indrekluuk/PlantWateringSystem/PCB/WateringSystem.kicad_pcb

## KiCad design PCB/WateringSystem.kicad_pcb (2018-07-01)

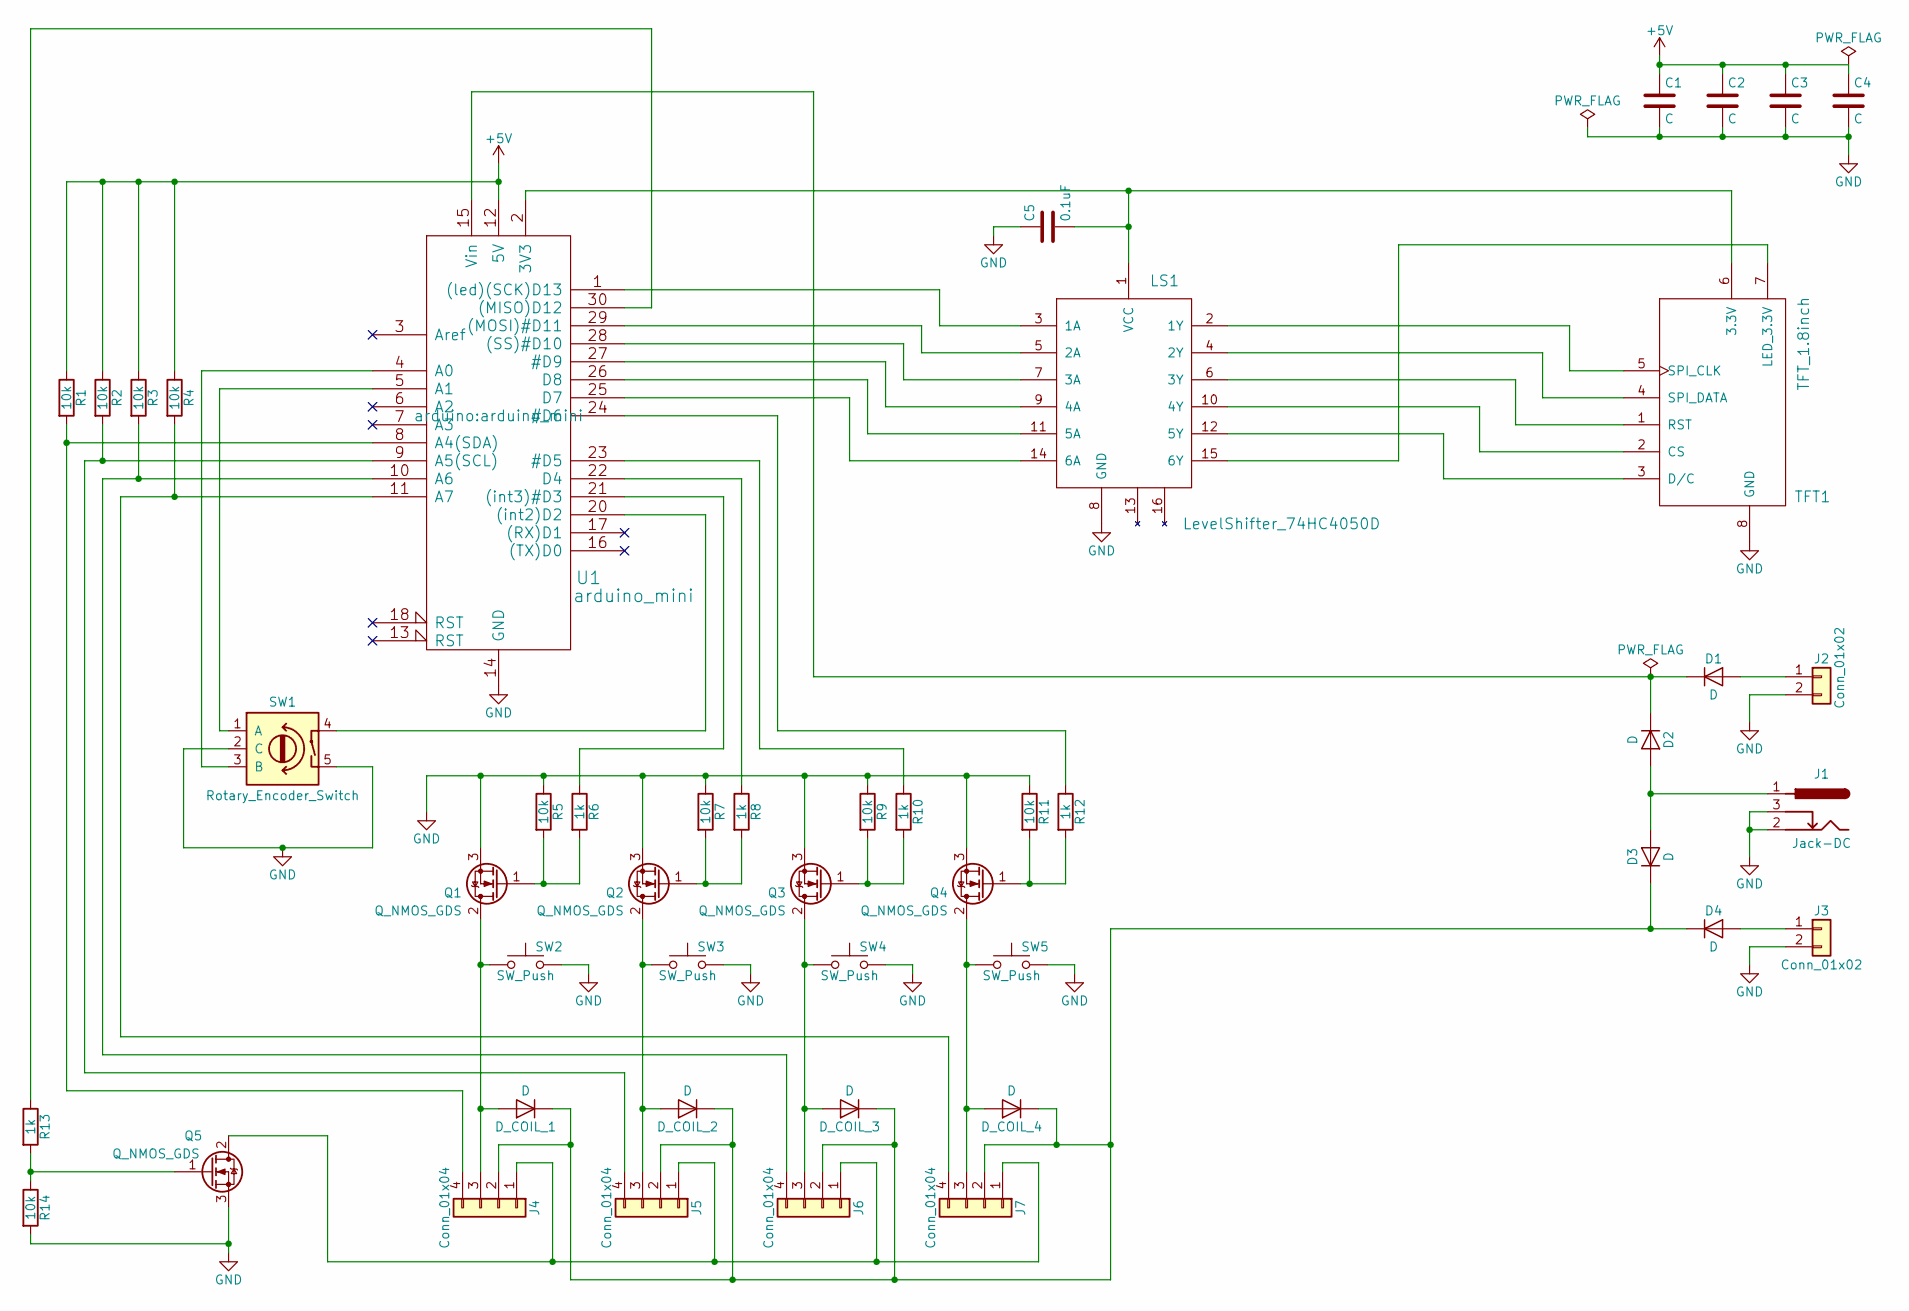
[picture p1: schematic WateringSystem.sch]

Parts:
C1, C2: C; C_1206_HandSoldering
C3, C4: C; C_Radial_D5_L6_P2.5
C5: 0.1uF; C_1206_HandSoldering
D1, D2, D3, D4: D; Diode_TO-247_Vertical
D_COIL_1, D_COIL_2, D_COIL_3, D_COIL_4: D; Diode_DO-35_SOD27_Horizontal_RM10
J1: Jack-DC; BARREL_JACK
J2, J3: Conn_01x02; Pin_Header_Straight_1x02
J4, J5, J6, J7: Conn_01x04; Pin_Header_Straight_1x04
LS1: LevelShifter_74HC4050D; SOP-16_4.4x10.4mm_Pitch1.27mm
Q1, Q2, Q3, Q4, Q5: Q_NMOS_GDS; TO-220_Vertical
R1, R2, R3, R4, R5, R7, R9, R11, R14: 10k; R_1206_HandSoldering
R6, R8, R10, R12, R13: 1k; R_1206_HandSoldering
SW1: Rotary_Encoder_Switch; RotaryEncoder
SW2, SW3, SW4, SW5: SW_Push; SW_PUSH_6mm_h5mm
TFT1: TFT_1.8inch; Pin_Header_Straight_1x08
U1: arduino_mini

Connections:
+5V: C1.1, C2.1, C3.1, C4.1, R1.1, R2.1, R3.1, R4.1, U1.12 (5V)
GND: C1.2, C2.2, C3.2, C4.2, C5.1, J1.2, J1.3, J2.2, J3.2, LS1.8 (GND), Q1.3 (S), Q2.3 (S), Q3.3 (S), Q4.3 (S), Q5.3 (S), R5.1, R7.1, R9.1, R11.1, R14.2, SW1.2 (C), SW1.5, SW2.2, SW3.2, SW4.2, SW5.2, TFT1.8 (GND), U1.14 (GND), U1.19 (GND)
unnamed: C5.2, LS1.1 (VCC), TFT1.6 (3.3V), U1.2 (3V3)
unnamed: D1.1 (K), D2.1 (K), U1.15 (Vin)
unnamed: D1.2 (A), J2.1
unnamed: D2.2 (A), D3.2 (A), J1.1
unnamed: D3.1 (K), D4.1 (K), D_COIL_1.1 (K), D_COIL_2.1 (K), D_COIL_3.1 (K), D_COIL_4.1 (K), J4.2, J5.2, J6.2, J7.2
unnamed: D4.2 (A), J3.1
unnamed: D_COIL_1.2 (A), J4.3, Q1.2 (D), SW2.1
unnamed: D_COIL_2.2 (A), J5.3, Q2.2 (D), SW3.1
unnamed: D_COIL_3.2 (A), J6.3, Q3.2 (D), SW4.1
unnamed: D_COIL_4.2 (A), J7.3, Q4.2 (D), SW5.1
unnamed: J4.1, J5.1, J6.1, J7.1, Q5.2 (D)
unnamed: J4.4, R1.2, U1.8 (A4(SDA))
unnamed: J5.4, R2.2, U1.9 (A5(SCL))
unnamed: J6.4, R3.2, U1.10 (A6)
unnamed: J7.4, R4.2, U1.11 (A7)
unnamed: LS1.2 (1Y), TFT1.5 (SPI_CLK)
unnamed: LS1.3 (1A), U1.1 ((led)(SCK)D13)
unnamed: LS1.4 (2Y), TFT1.4 (SPI_DATA)
unnamed: LS1.5 (2A), U1.29 ((MOSI)#D11)
unnamed: LS1.6 (3Y), TFT1.1 (RST)
unnamed: LS1.7 (3A), U1.28 ((SS)#D10)
unnamed: LS1.9 (4A), U1.27 (#D9)
unnamed: LS1.10 (4Y), TFT1.2 (CS)
unnamed: LS1.11 (5A), U1.26 (D8)
unnamed: LS1.12 (5Y), TFT1.3 (D/C)
unnamed: LS1.14 (6A), U1.25 (D7)
unnamed: LS1.15 (6Y), TFT1.7 (LED_3.3V)
unnamed: Q1.1 (G), R5.2, R6.2
unnamed: Q2.1 (G), R7.2, R8.2
unnamed: Q3.1 (G), R9.2, R10.2
unnamed: Q4.1 (G), R11.2, R12.2
unnamed: Q5.1 (G), R13.2, R14.1
unnamed: R6.1, U1.21 ((int3)#D3)
unnamed: R8.1, U1.22 (D4)
unnamed: R10.1, U1.23 (#D5)
unnamed: R12.1, U1.24 (#D6)
unnamed: R13.1, U1.30 ((MISO)D12)
unnamed: SW1.1 (A), U1.5 (A1)
unnamed: SW1.3 (B), U1.4 (A0)
unnamed: SW1.4, U1.20 ((int2)D2)

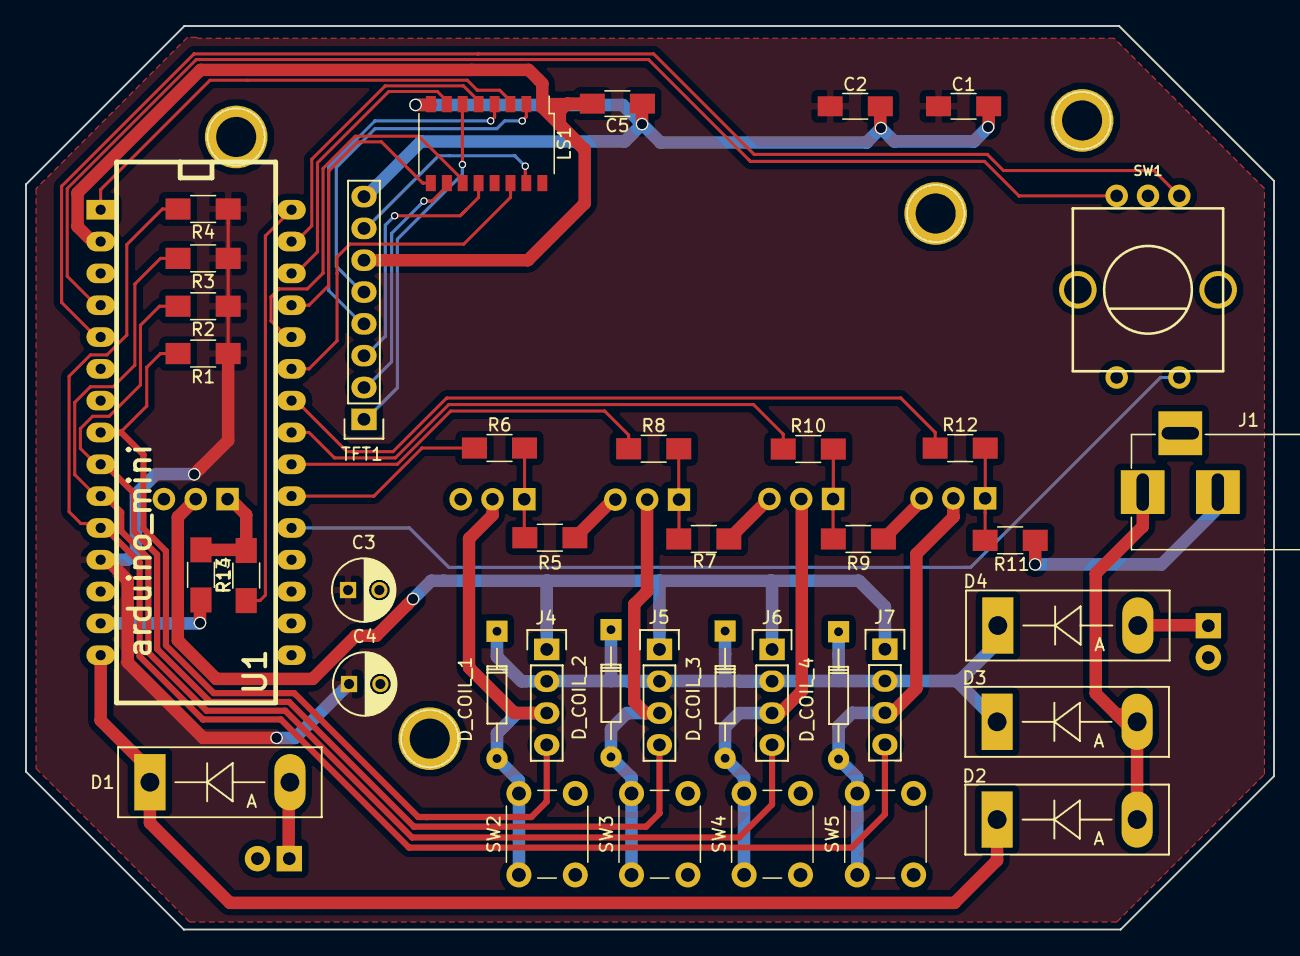
[picture p2: board WateringSystem.kicad_pcb from above]

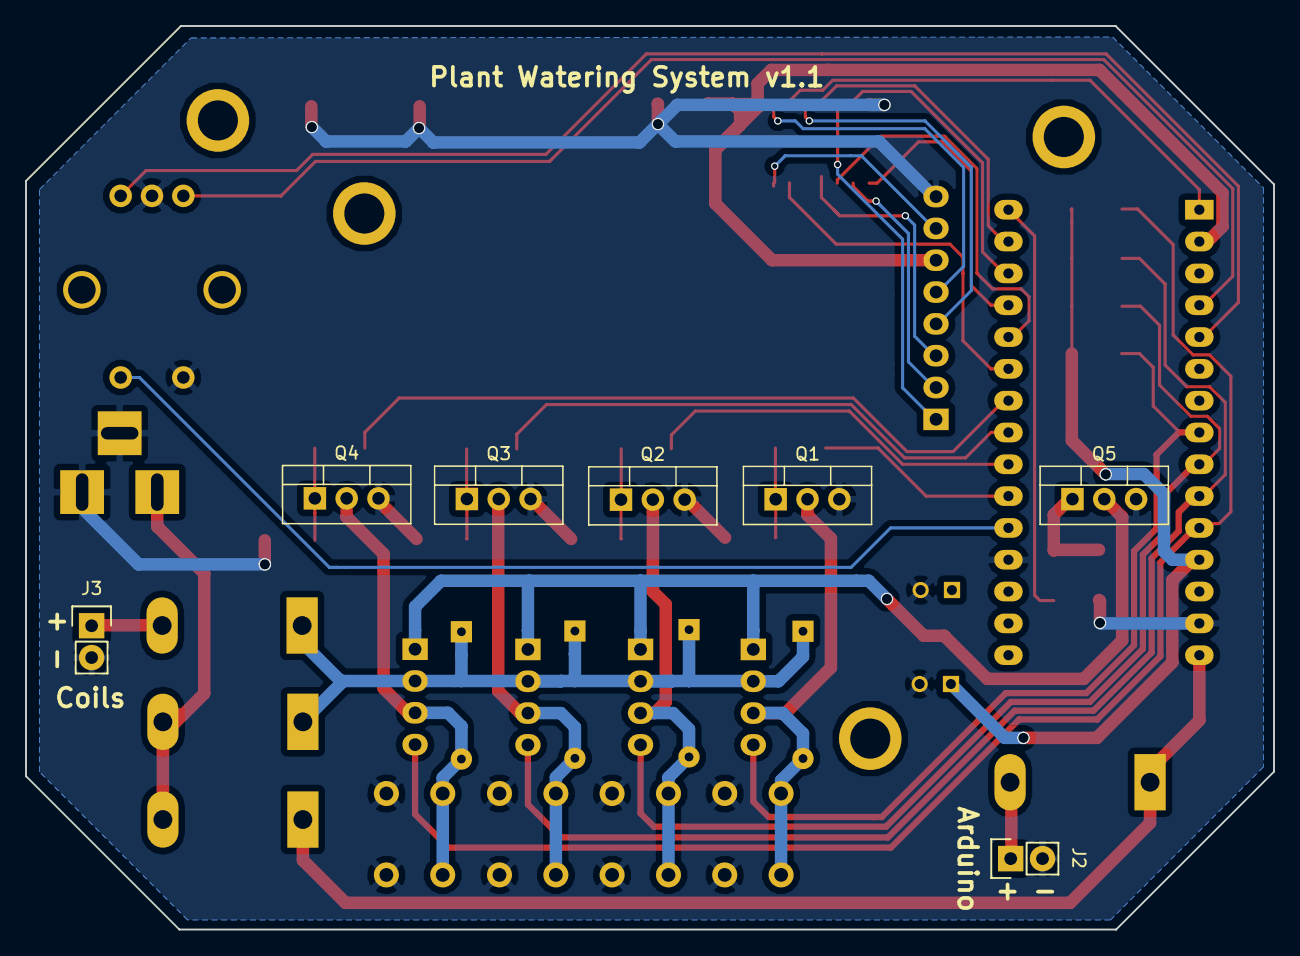
[picture p3: board WateringSystem.kicad_pcb from below]

Board: 2 copper layers, 99.6 x 72.1 mm, 47 parts (7 on the bottom side), 42 nets.
