indrekluuk/PlantWateringSystem/src/PlantWateringSystem/configuration.h

//
// Created by indrek on 28.06.2018.
//

#ifndef PLANTWATERINGSYSTEM_CONFIGURATION_H
#define PLANTWATERINGSYSTEM_CONFIGURATION_H


#include "Arduino.h"


const int TFT_PIN_CS = 9;
const int TFT_PIN_RS = 8;
const int TFT_PIN_RST = 10;
const int TFT_PIN_BACK_LIGHT = 7;

const int BUTTON_PIN_ROT_1 = A1;
const int BUTTON_PIN_ROT_2 = A0;
const int BUTTON_PIN_PUSH = 2;

const int SENSOR_PIN_POWER = 12;
const int SENSOR_PIN_1 = A4;
const int SENSOR_PIN_2 = A5;
const int SENSOR_PIN_3 = A6;
const int SENSOR_PIN_4 = A7;

const int COIL_PIN_1 = 3;
const int COIL_PIN_2 = 4;
const int COIL_PIN_3 = 5;
const int COIL_PIN_4 = 6;


#endif //PLANTWATERINGSYSTEM_CONFIGURATION_H
