indrekluuk/PlantWateringSystem/(commit log)

2018-05-19 Initial commit. PCB design
    [WateringSystem.kicad_pcb, WateringSystem.sch]
2018-05-19 CLion project files
    [WateringSystem.kicad_pcb]
2018-06-28 fixed screen connector on PCB
    [WateringSystem-B.Cu.gbl, WateringSystem-B.Mask.gbs, WateringSystem-B.SilkS.gbo, WateringSystem-Edge.Cuts.gm1, WateringSystem-F.Cu.gtl, WateringSystem-F.Mask.gts, WateringSystem-F.SilkS.gto, WateringSystem.drl]
2018-06-28 button working
    [configuration.h]
2018-06-29 read sensors
    [configuration.h]
2018-06-29 Consolidated coils and moisture sensor to connector
2018-07-01 fixed and updated PCB
    [WateringSystem-B.Cu.gbl, WateringSystem-B.Mask.gbs, WateringSystem-B.SilkS.gbo, WateringSystem-Edge.Cuts.gm1, WateringSystem-F.Cu.gtl, WateringSystem-F.Mask.gts, WateringSystem-F.SilkS.gto, WateringSystem.drl]
